alexmlucas/switchcraft/electronics/switchcraft/switchcraft.kicad_pcb

## KiCad design electronics/switchcraft/switchcraft.kicad_pcb (2025-12-11)

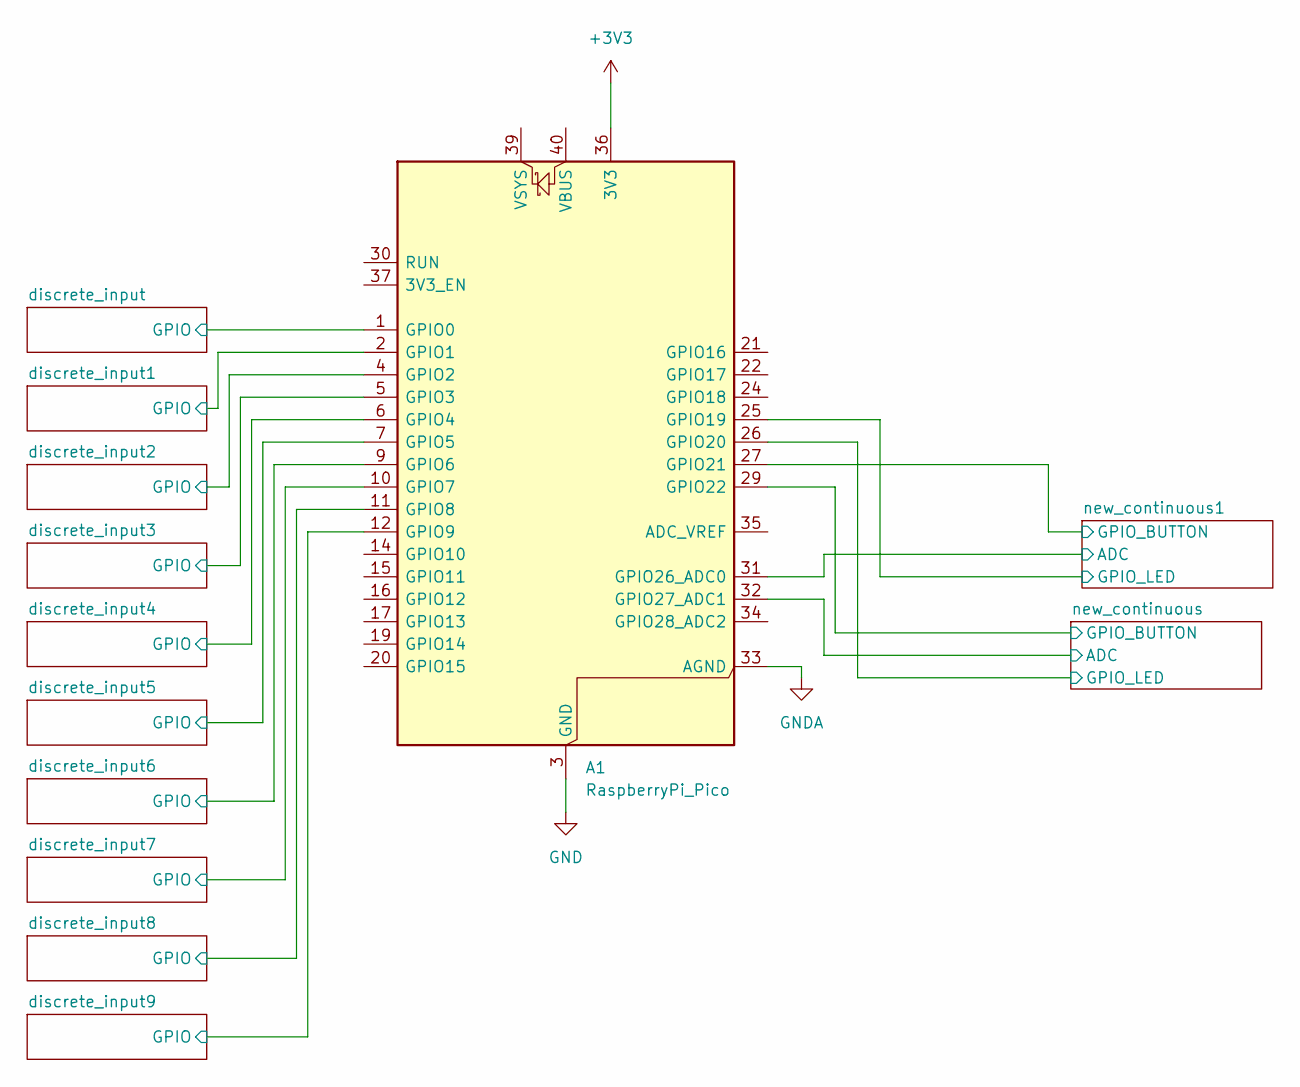
[picture p1: schematic switchcraft.kicad_sch]

Parts:
A1: RaspberryPi_Pico; RaspberryPi_Pico_Common_Unspecified

Connections:
+3V3: A1.36 (3V3); also elsewhere on the board
/discrete_input1/GPIO: A1.2 (GPIO1); also elsewhere on the board
/discrete_input2/GPIO: A1.4 (GPIO2); also elsewhere on the board
/discrete_input3/GPIO: A1.5 (GPIO3); also elsewhere on the board
/discrete_input4/GPIO: A1.6 (GPIO4); also elsewhere on the board
/discrete_input5/GPIO: A1.7 (GPIO5); also elsewhere on the board
/discrete_input6/GPIO: A1.9 (GPIO6); also elsewhere on the board
/discrete_input7/GPIO: A1.10 (GPIO7); also elsewhere on the board
/discrete_input8/GPIO: A1.11 (GPIO8); also elsewhere on the board
/discrete_input9/GPIO: A1.12 (GPIO9); also elsewhere on the board
/discrete_input/GPIO: A1.1 (GPIO0); also elsewhere on the board
/new_continuous1/ADC: A1.31 (GPIO26_ADC0); also elsewhere on the board
/new_continuous1/GPIO_BUTTON: A1.27 (GPIO21); also elsewhere on the board
/new_continuous1/GPIO_LED: A1.25 (GPIO19); also elsewhere on the board
/new_continuous/ADC: A1.32 (GPIO27_ADC1); also elsewhere on the board
/new_continuous/GPIO_BUTTON: A1.29 (GPIO22); also elsewhere on the board
/new_continuous/GPIO_LED: A1.26 (GPIO20); also elsewhere on the board
GND: A1.3 (GND), A1.8 (GND), A1.13 (GND), A1.18 (GND), A1.23 (GND), A1.28 (GND), A1.38 (GND); also elsewhere on the board
GNDA: A1.33 (AGND); also elsewhere on the board

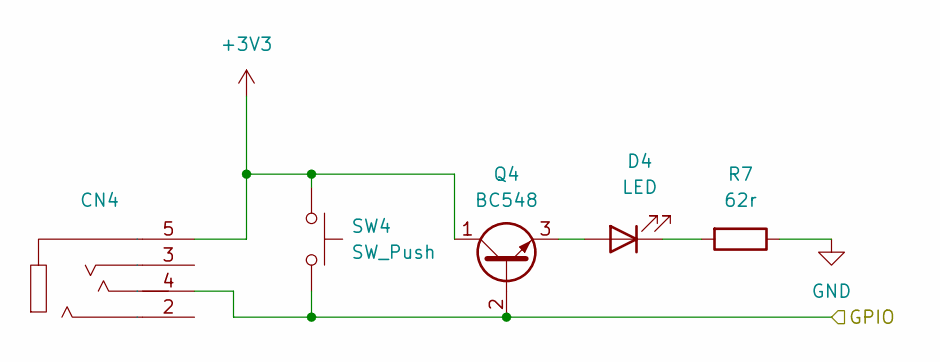
[picture p2: schematic discrete_input.kicad_sch]

Parts:
CN4: PJ-320A
D4: LED; LED_D3.0mm
Q4: BC548; TO-92_Inline_Wide
R7: 62r; R_Axial_DIN0207_L6.3mm_D2.5mm_P7.62mm_Horizontal
SW4: SW_Push; SW_PUSH_6mm

Connections:
+3V3: CN4.5, Q4.1 (C), SW4.1; also elsewhere on the board
/discrete_input/GPIO: CN4.4, Q4.2 (B), SW4.2; also elsewhere on the board
GND: R7.1; also elsewhere on the board
unnamed: D4.2 (A), Q4.3 (E)
unnamed: D4.1 (K), R7.2

Parts of its further copies:
CN5, CN6, CN7, CN8, CN9, CN10, CN11, CN12, CN13: PJ-320A
D5, D6, D7, D8, D9, D10, D11, D12, D13: LED; LED_D3.0mm
Q5, Q6, Q7, Q8, Q9, Q10, Q11, Q12, Q13: BC548; TO-92_Inline_Wide
R8, R9, R10, R11, R12, R13, R14, R15, R16: 62r; R_Axial_DIN0207_L6.3mm_D2.5mm_P7.62mm_Horizontal
SW5, SW6, SW7, SW8, SW9, SW10, SW11, SW12, SW13: SW_Push; SW_PUSH_6mm

Connections of its further copies:
+3V3: CN5.5, CN6.5, CN7.5, CN8.5, CN9.5, CN10.5, CN11.5, CN12.5, CN13.5, Q5.1 (C), Q6.1 (C), Q7.1 (C), Q8.1 (C), Q9.1 (C), Q10.1 (C), Q11.1 (C), Q12.1 (C), Q13.1 (C), SW5.1, SW6.1, SW7.1, SW8.1, SW9.1, SW10.1, SW11.1, SW12.1, SW13.1; also elsewhere on the board
/discrete_input1/GPIO: CN5.4, Q5.2 (B), SW5.2; also elsewhere on the board
/discrete_input2/GPIO: CN6.4, Q6.2 (B), SW6.2; also elsewhere on the board
/discrete_input3/GPIO: CN7.4, Q7.2 (B), SW7.2; also elsewhere on the board
/discrete_input4/GPIO: CN8.4, Q8.2 (B), SW8.2; also elsewhere on the board
/discrete_input5/GPIO: CN9.4, Q9.2 (B), SW9.2; also elsewhere on the board
/discrete_input6/GPIO: CN10.4, Q10.2 (B), SW10.2; also elsewhere on the board
/discrete_input7/GPIO: CN11.4, Q11.2 (B), SW11.2; also elsewhere on the board
/discrete_input8/GPIO: CN12.4, Q12.2 (B), SW12.2; also elsewhere on the board
/discrete_input9/GPIO: CN13.4, Q13.2 (B), SW13.2; also elsewhere on the board
GND: R8.1, R9.1, R10.1, R11.1, R12.1, R13.1, R14.1, R15.1, R16.1; also elsewhere on the board
unnamed: D5.2 (A), Q5.3 (E)
unnamed: D5.1 (K), R8.2
unnamed: D6.2 (A), Q6.3 (E)
unnamed: D6.1 (K), R9.2
unnamed: D7.2 (A), Q7.3 (E)
unnamed: D7.1 (K), R10.2
unnamed: D8.2 (A), Q8.3 (E)
unnamed: D8.1 (K), R11.2
unnamed: D9.2 (A), Q13.3 (E)
unnamed: D9.1 (K), R13.2
unnamed: D10.2 (A), Q12.3 (E)
unnamed: D10.1 (K), R14.2
unnamed: D11.2 (A), Q11.3 (E)
unnamed: D11.1 (K), R15.2
unnamed: D12.2 (A), Q9.3 (E)
unnamed: D12.1 (K), R16.2
unnamed: D13.2 (A), Q10.3 (E)
unnamed: D13.1 (K), R12.2

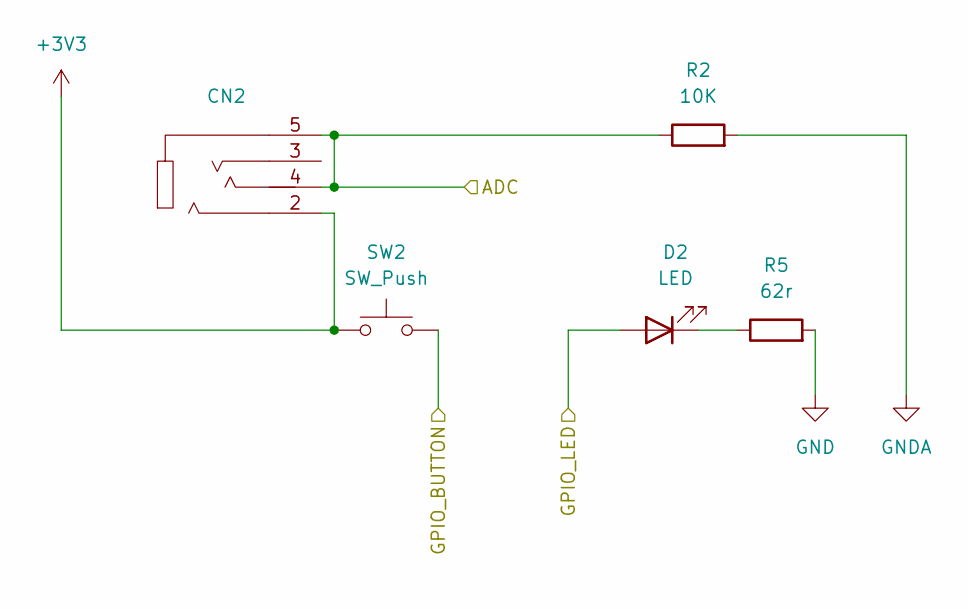
[picture p3: schematic new_continuous.kicad_sch]

Parts:
CN2: PJ-320A
D2: LED; LED_D3.0mm
R2: 10K; R_Axial_DIN0207_L6.3mm_D2.5mm_P7.62mm_Horizontal
R5: 62r; R_Axial_DIN0207_L6.3mm_D2.5mm_P7.62mm_Horizontal
SW2: SW_Push; SW_PUSH_6mm

Connections:
+3V3: CN2.2, SW2.1; also elsewhere on the board
/new_continuous1/ADC: CN2.4, CN2.5, R2.1; also elsewhere on the board
/new_continuous1/GPIO_BUTTON: SW2.2; also elsewhere on the board
/new_continuous1/GPIO_LED: D2.2 (A); also elsewhere on the board
GND: R5.2; also elsewhere on the board
GNDA: R2.2; also elsewhere on the board
unnamed: D2.1 (K), R5.1

Parts of its further copies:
CN3: PJ-320A
D19: LED; LED_D3.0mm
R3: 10K; R_Axial_DIN0207_L6.3mm_D2.5mm_P7.62mm_Horizontal
R6: 62r; R_Axial_DIN0207_L6.3mm_D2.5mm_P7.62mm_Horizontal
SW3: SW_Push; SW_PUSH_6mm

Connections of its further copies:
+3V3: CN3.2, SW3.1; also elsewhere on the board
/new_continuous/ADC: CN3.4, CN3.5, R3.1; also elsewhere on the board
/new_continuous/GPIO_BUTTON: SW3.2; also elsewhere on the board
/new_continuous/GPIO_LED: D19.2 (A); also elsewhere on the board
GND: R6.2; also elsewhere on the board
GNDA: R3.2; also elsewhere on the board
unnamed: D19.1 (K), R6.1

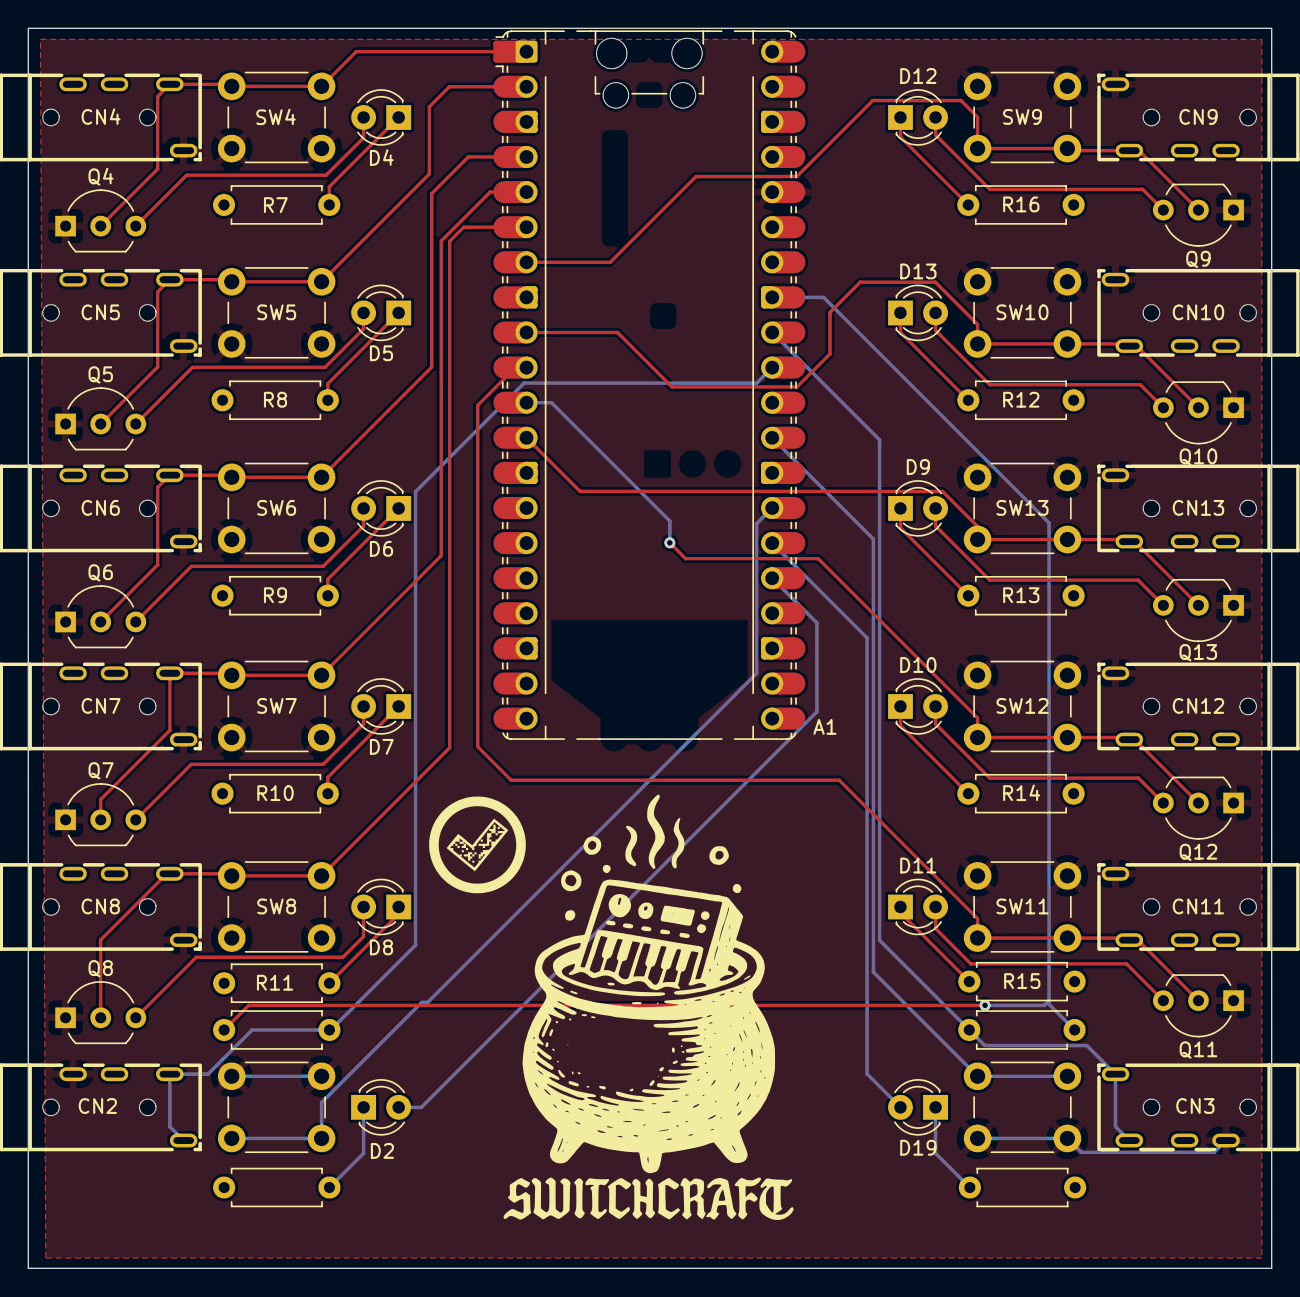
[picture p4: board switchcraft.kicad_pcb from above]

Board: 2 copper layers, 90.0 x 89.7 mm, 61 parts (0 on the bottom side), 41 nets.
