alexmlucas/switchcraft/firmware/src/crc32.c

#include "crc32.h"

uint32_t crc32(const uint8_t *data, size_t len) {
    uint32_t crc = 0xFFFFFFFFu;
    for (size_t i = 0; i < len; i++) {
        crc ^= data[i];
        for (int b = 0; b < 8; b++)
            crc = (crc >> 1) ^ (0xEDB88320u & -(crc & 1u));
    }
    return crc ^ 0xFFFFFFFFu;
}
