alexmlucas/switchcraft/(commit log)

2026-10-12 Add config interface plan and CLAUDE.md
    Records the agreed design for the browser-based configuration interface
    (WebMIDI + SysEx, two USB MIDI cables, rule-table firmware, Blockly,
    presets, browser synth) and the priority order for the 2026-11-27 demo.
2026-10-13 Add pin map and SysEx/rule-table spec
    - docs/pin-map.md: GPIO assignments extracted from the KiCad PCB, in panel
    order, plus the circuit details the firmware depends on (active-high
    inputs with no external pull-downs, hardware-driven switch LEDs).
    - docs/sysex-rule-table-spec.md: SysEx protocol (framing, nibble encoding,
    chunked table transfer, slot commands, live reports) and rule-table
    format v1 (globals, rules, sequences, flash slot layout, validation).
    - The board is a stock Raspberry Pi Pico (2 MB flash); the original
    firmware is lost. Updated CLAUDE.md and the plan to match, and added
    tap triggers and analog inputs to priority item 1.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
2026-10-13 Add Pico firmware and Python config tool
    Firmware (Pico SDK 2.1.1 + TinyUSB) implementing spec v1:
    - USB MIDI with two virtual cables; musical output on both, config SysEx
    on cable 2 only. Raw packet I/O, since TinyUSB's stream API mixes cables.
    - SysEx protocol: identify, chunked table read/write with CRC, slot
    save/load/erase, all notes off, live input/analog/slot reports.
    - Rule table validation and parsing; built-in default scale player.
    - 8 preset slots plus a boot-slot sector at the end of flash, each with
    magic number and CRC.
    - Inputs: debounce, lockout, tap/hold, analog smoothing with hysteresis,
    PWM analog LEDs.
    - Engine: notes (hold/latch/one-shot, scale degrees), CCs, sha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
2026-10-13 Add browser config page: form view
    web/index.html: the form view (priority item 1). Connects over Web MIDI
    with SysEx, finds the config port by which input answers IDENTIFY, and
    edits one action per switch (scale note, fixed note, transpose, nothing),
    key/scale/octave, analog CCs, channel, velocity and repeat-press lockout.
    Edits are sent within ~120 ms and saved to the active preset after a 2 s
    pause. Shows presses, analog levels and the last note live, switches and
    creates presets, reconnects on replug, and explains presets made by other
    editors instead of overwriting them. Works from file:// with no server.
    web/switchcraft.js: protocol, rule-table builder/parser and Board class,
    free of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
2026-10-13 Add sequences and arpeggios to the form view (priority item 2)
    - Page: a "Sequences and arpeggios" card with four sequences (A-D): plays
    by itself in time or one note per press, scale or fixed notes with
    rests, order, octaves, speed, note length, shared tempo.
    - New switch actions: play sequence (while held / start-stop / once,
    optionally starting on the beat), step through, restart. Tiles warn
    when a switch points at an empty or step-by-step sequence.
    - switchcraft.js parses and builds sequence sections fully; the form
    accepts tables whose sequences fit it.
    - tools/check_page_tables.py sends the page's sample tables to a real
    board to confirm the firmware accepts them.
    - tools/s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
2026-10-13 Add built-in browser synth for auditioning
    web/synth.js: a small Web Audio synth (two oscillators -> low-pass filter
    -> amp per voice, 16 voices with oldest reused, limiter on the output).
    Responds to CC 1 vibrato, CC 7 volume, CC 74 brightness, pitch bend and
    all-notes-off. Four sounds. Built from the browser's own audio nodes so
    it works from file:// with no extra files; AMY was considered but its web
    build needs a server with cross-origin isolation.
    The page plays everything the board copies to port 2 through it: a
    "Sound" button in the header (audio needs a click), sound and volume
    settings remembered in this browser, and "All notes off" also silences
    it.
    tools/run_web_tests.py runs we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
2026-10-13 Analog calibration and invert, synth echo, starter templates
    Firmware 0.2.0: analog_max may be less than analog_min to invert an
    analog input (spec B.3). The analog jacks read a divider (sensor to 3.3 V,
    10 k to ground), so a 10 k pedal spans only about half the ADC range,
    backwards; calibration maps the real range onto 0-127.
    Page:
    - Per analog input: "Set range" records the lowest and highest readings
    while the sensor is moved (at full range, so every movement is
    reported), "Invert", and "Full range".
    - Synth: tempo-synced echo (quarter, dotted eighth, eighth, triplet,
    sixteenth) with repeats and level, following the preset's tempo.
    - Starter templates: scale player, chord arpeggiat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
2026-10-13 Board-wide analog calibration (firmware 0.3.0)
    Calibration describes the hardware plugged in, not the music, so it now
    lives on the board instead of in each preset:
    - Spec: the boot-state sector becomes a board settings record ("SCB2":
    power-up slot plus analog min/max). The pre-0.3.0 record is still read,
    keeping its boot slot. New CALIBRATION_GET / CALIBRATION_SET commands;
    SET can apply without saving, for a temporary full range while a new
    range is measured. GLOBALS bytes 30-39 are reserved (written as 0,
    ignored when read), so existing presets still load.
    - Defaults are for the Logitech Adaptive Gaming Kit variable triggers,
    measured at about 3850 at rest and 2250 fully pre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
2026-10-13 Blocks view (Blockly), reversed analog inputs (firmware 0.3.1)
    Blocks view (priority item 3):
    - web/blocks.js: 15 colour-coded blocks. Events (when switch is
    pressed/released/held/tapped, every <note value>, when this preset
    starts, when an analog input moves); sound (play scale note, play note,
    set controller); sequences (play/step/stop/restart, select, and a
    "sequence A plays" block whose notes are scale steps like 1 3 5 or names
    like C4 E4); changes (transpose, change key, switch preset); and a
    "Preset settings" block. compile() turns a workspace into a rule table;
    decompile() turns any table into blocks, carrying values the blocks
    don't show in block data so nothing is lo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
2026-10-13 Save and open presets as files; fix Blocks-to-Form crash
    Preset files (finishes priority item 3): "Save to file" downloads
    <name>.switchcraft.json with a format name and version, the rule table as
    hex (exactly what the board runs) and the Blockly workspace (layout and
    unfinished blocks included; converted from the table when saving from the
    Form view). "Open file..." checks the file (format, version, table length
    and format), asks before replacing the current preset, and plays it
    straight away. Saved blocks reopen as they were; if they won't load, the
    blocks are rebuilt from the table.
    Fixes:
    - Switching from Blocks to Form crashed: the form reader expected the
    table's optional "extra sec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
2026-10-13 Euclidean rhythms (priority item 4), live edits (firmware 0.4.1)
    Euclidean rhythms (spec B.6.1): the reserved EUCLID section (0x04) gives a
    clock-mode sequence k hits over n steps rotated by r; position i is a hit
    if ((i + r) * k) % n < k. A hit plays the sequence's next note, a miss is
    a rest, so one-note sequences become drum parts and chords become
    Euclidean arpeggios. Runs on the board's clock.
    Live edits (spec A.4): WRITE_COMMIT bit 1 (RESTART) separates a new
    preset from an edit. An edit keeps playing clock-mode sequences going
    (position, gate mode, owner), keeps transpose and doesn't fire "when this
    preset starts" rules, so rhythms, tempo and notes can be changed while
    listening. Wit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
2026-10-13 CC modulation: LFOs and envelopes (priority item 5, firmware 0.5.0)
    Spec B.6.2: the MODULATOR section (0x05) defines up to four modulators,
    each an LFO (sine, triangle, saw, square, random; free 0.01-20 Hz or
    synced to the clock) or an envelope (attack, decay, sustain, release;
    retriggers from its current value; can follow a sequence's notes). Each
    sends a CC, pitch bend (14-bit) or channel pressure between a "from" and
    "to" value, straight or curved, at most 100 times a second and only on
    change. Actions MOD_RUN (hold / latch / once) and MOD_STOP. AD, AR,
    ADSR and press-driven sweeps (AR on a held switch) are all envelopes.
    Live edits keep running modulators going.
    Firmware: new modulators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
2026-10-13 Follow external MIDI clock (priority item 6, firmware 0.6.1)
    Spec B.11: MIDI clock (0xF8) on the music port drives the board's clock,
    one tick per message, unless the preset sets IGNORE_CLOCK (GLOBALS byte
    25, bit 0). The tempo is estimated from the clock spacing (for note
    lengths and synced LFOs between ticks). Start makes the next clock tick 0
    and restarts playing clock-mode sequences and synced LFOs, so they line up
    with the DAW; Continue resumes; Stop, or no clock for 0.5 s, returns to
    the preset's tempo straight away and sequences keep playing. New CLOCK
    report (0x63): source and tempo, on change and once a second while
    following.
    Page: "Follow MIDI clock from a DAW" setting (form and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
2026-10-13 MIDI file import into sequences (priority item 7)
    "Import a MIDI file..." (Sequences card and Blocks card) reads a standard
    MIDI file in the page (format 0/1; running status, note-on velocity 0,
    tempo, track names), lists its parts by track and channel (tuned parts
    before drums), and turns one into a sequence: chords keep their top note,
    notes snap to a grid (32nds to beats), lengths are kept as step lengths
    and real gaps become rests when it plays in time; stepping through one
    note per press leaves rests out. Trim with "start at note" and "number of
    notes" (live preview), choose the sequence and optionally the file's
    tempo. No firmware change: the board already plays step lengths.
    Sequence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
2026-10-16 Style the editor with the noise guaranteed brand
    brand.css restyles the page from BRAND.md in noiseguaranteed.github.io:
    cream paper, Atkinson Hyperlegible Mono, square black-bordered cards,
    numbered lab-sheet headings, black/green selected buttons with magenta
    hover, green header with the logo and a pixel-noise strip, and a
    brand-derived dark mode. The Blockly theme uses the same colours and font.
    Font, logo and noise.js are copied in so the page stays offline-capable.
    Also fixes two phone-width layout bugs: the analog mapping controls
    landed in the narrow 4ch column (the rule targeted the select, which is
    now wrapped), and the wrapped sticky header covered too much screen.
    Co-Authored-By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
2026-10-16 Piano roll editor for sequences (priority item 8, work in progress)
    A page-only view of a sequence with time across and pitch up, as an
    alternative to the note list: click to add or remove notes, drag to
    change pitch, drag the right edge to change length (clock mode), with
    arrow-key and Delete editing for keyboard users. The editing rules are
    plain functions in pianoroll.js, covered by four new tests in test.html.
    The list/roll choice is remembered in this browser.
